adrianosvc/ibc_coupling/amplifier_parts.ods

Label | Quantidade | Part Number | Descrição | Cod. DIGIKEY | Unitário | Valor
R12 | 1 |  | Resistor 0603 16.2k 0.5% | 311-16.2KDCT-ND | 0.2 | 0.2 | 10 kHz Chebyshev 1 dB ripple.
R13 | 1 |  | Resistor 0603 8.87k 0.5% | 311-8.87KDCT-ND | 0.2 | 0.2
R14 | 1 |  | Resistor 0603 24.9k 0.5% | 311-24.9KDCT-ND | 0.2 | 0.2 | For 100 kHz
R15 | 1 |  | Resistor 0603 13.7k 0.5% | 311-2421-1-ND | 0.12 | 0.12 | R12 = 1.62k
C8 | 1 |  | Capacitor PPS 0805 2% 10nF 16V | PCF1177CT-ND | 0.49 | 0.49 | R13 = 887
C9 | 1 |  | Capacitor PPS 0603 2% 180pF 16V | PCF1444CT-ND | 0.49 | 0.49 | R14 = 2.49k
C10 | 1 |  | Capacitor PPS 0603 2% 2.7nF 16V | PCF1458CT-ND | 0.45 | 0.45 | R15 = 1.37k
C11 | 1 |  | Capacitor PPS 0603 2% 1nF 16V | PCF1453CT-ND | 0.45 | 0.45
C3,C4,C5 C6,C7 C12,C13 | 7 |  | Capacitor 100nF 25V X7R 0603 | 445-5667-1-ND | 0.1 | 0.7
C2,C14 | 2 |  | Capacitor 1uF 25V X7R 0603 | 1276-1184-1-ND | 0.1 | 0.2
R1,R2,R8 | 3 |  | Resistor 1 kOhm .1W 0603 | 541-3949-1-ND | 0.1 | 0.3
R10,R11 | 2 |  | Resistor 10 kOhm .1W 0603 | RMCF0603FT10K0CT-ND | 0.1 | 0.2
R3 | 1 |  | Resistor 100 Ohm .1W 0603 | RMCF0603FT100RCT-ND | 0.1 | 0.1
R7 | 1 |  | Resistor 160 kOhm .1W 0603 | 541-160KHCT-ND | 0.1 | 0.1
R4,R5,R6 | 3 |  | Resistor 1.78 kOhm .1W 0603 | RMCF0603FT1K78CT-ND | 0.1 | 0.3
R9 | 1 |  | Resistor 66.5 kOhm .1W 0603 | 311-66.5KHRCT-ND | 0.1 | 0.1
C1 | 1 |  | Capacitor 4.7nF X7R 16V 0603 | 399-9091-1-ND | 0.1 | 0.1
D1,D2,D3 D4,D5,D6 | 6 | FDLL333 | Diodo baixa corrente de fuga SOD-80 | FDLL333CT-ND | 0.27 | 1.62
IC1 | 1 | INA819 | Amplificador de instrumentação SOIC-8 | 296-53403-ND | 5.74 | 5.74
IC3 | 1 | TLV4171 | Amplificador operacional quádruplo SOIC-14 | 296-46563-1-ND | 1.71 | 1.71
IC2 | 1 | TLV2171 | Amplificador operacional duplo SOIC-8 | 296-44865-1-ND | 1.28 | 1.28
 |  |  |  |  | TOTAL (US$) | 15.05
