adrianosvc/ibc_coupling/driver_parts.ods

ID | Quantidade | Part Number | Descrição | Cod. DIGIKEY | Unitário | Valor
IC1, IC2 | 2 | TL487A | Conversor chaveado SOIC-14 | 296-10195-1-ND | 1.67 | 3.34
C1,C6,C11,C12,C14 | 5 |  | Cap. 100uF 25V low-ESR | 399-6118-ND | 0.27 | 1.35
L1,L2 | 2 |  | Indutor 220uH 600mA | 587-6014-1-ND | 0.32 | 0.64
R1,R2 | 2 |  | Resistor 1 Ohm .25W 1206 | 541-1.00FFCT-ND | 0.1 | 0.2
R7,R8 | 2 |  | Resistor 10 Ohm .1W 0603 | 541-2982-1-ND | 0.1 | 0.2
R4,R5 | 2 |  | Resistor 1.2 kOhm .1W 0603 | P1.20KHCT-ND | 0.1 | 0.2
R3,R6 | 2 |  | Resistor 16.9 kOhm .1W 0603 | 541-16.9KHCT-ND | 0.1 | 0.2
C2,C3,C7,C8,C9, C10,C13,C15 | 8 |  | Capacitor 100 nF 25V X7R 0603 | 445-5667-1-ND | 0.1 | 0.8
D1,D2,D3 | 3 | MBR05030T1G | Diodo Schottky 500mA SOD-23 | MBR0530T1GOSCT-ND | 0.39 | 1.17
IC3 | 1 | LM78L15 | Regulador de tensão Linear TO-92 | 497-13129-ND | 0.36 | 0.36
IC4 | 1 | LM79L15 | Regulador de tensão Linear TO-92 | MC79L15ACPREGOSCT-ND | 0.42 | 0.42
IC5,IC6 | 2 | LM324KADR | Amplificador operacional SOIC-14 | 296-18447-1-ND | 0.51 | 1.02
Q1,Q3,Q5 | 3 | BC846 | Transistor NPN uso geral SOT-23 | BC846BLT3GOSCT-ND | 0.14 | 0.42
Q2,Q4 | 2 | BC856 | Transistor PNP uso geral SOT-23 | BC856BLT1GOSCT-ND | 0.14 | 0.28
C4,C5 | 2 |  | Capacitor 270 pF 50 V C0G 0603 | 1276-1256-1-ND | 0.1 | 0.2
C16 | 1 |  | Capacitor 470 nF 25 V X7R 0603 | 732-7993-1-ND | 0.1 | 0.1
R12,R16,R17, R18,R19,R20 | 6 |  | Resistor 1 kOhm .1W 0603 | 541-3949-1-ND | 0.1 | 0.6
R9,R23,R25 | 3 |  | Resistor 2 kOhm .1W 0603 | 541-3953-1-ND | 0.1 | 0.3
R24,R26 | 2 |  | Resistor 510 Ohm .1W 0603 | 541-510HCT-ND | 0.1 | 0.2
R14 | 1 |  | Resistor 976 Ohm .1W 0603 | 311-976HRCT-ND | 0.1 | 0.1
R11 | 1 |  | Resistor 1.47 kOhm .1W 0603 | RMCF0603FT1K47CT-ND | 0.1 | 0.1
R15 | 1 |  | Resistor 14.7 kOhm .1W 0603 | RMCF0603FT14K7CT-ND | 0.1 | 0.1
R10 | 1 |  | Resistor 13 kOhm .1W 0603 | RMCF0603FT13K0CT-ND | 0.1 | 0.1
R13 | 1 |  | Resistor 4.87 kOhm .1W 0603 | RMCF0603FT4K87CT-ND | 0.1 | 0.1
 |  |  |  |  | TOTAL (US$) | 12.5
