adrianosvc/ibc_coupling/driver.pdf

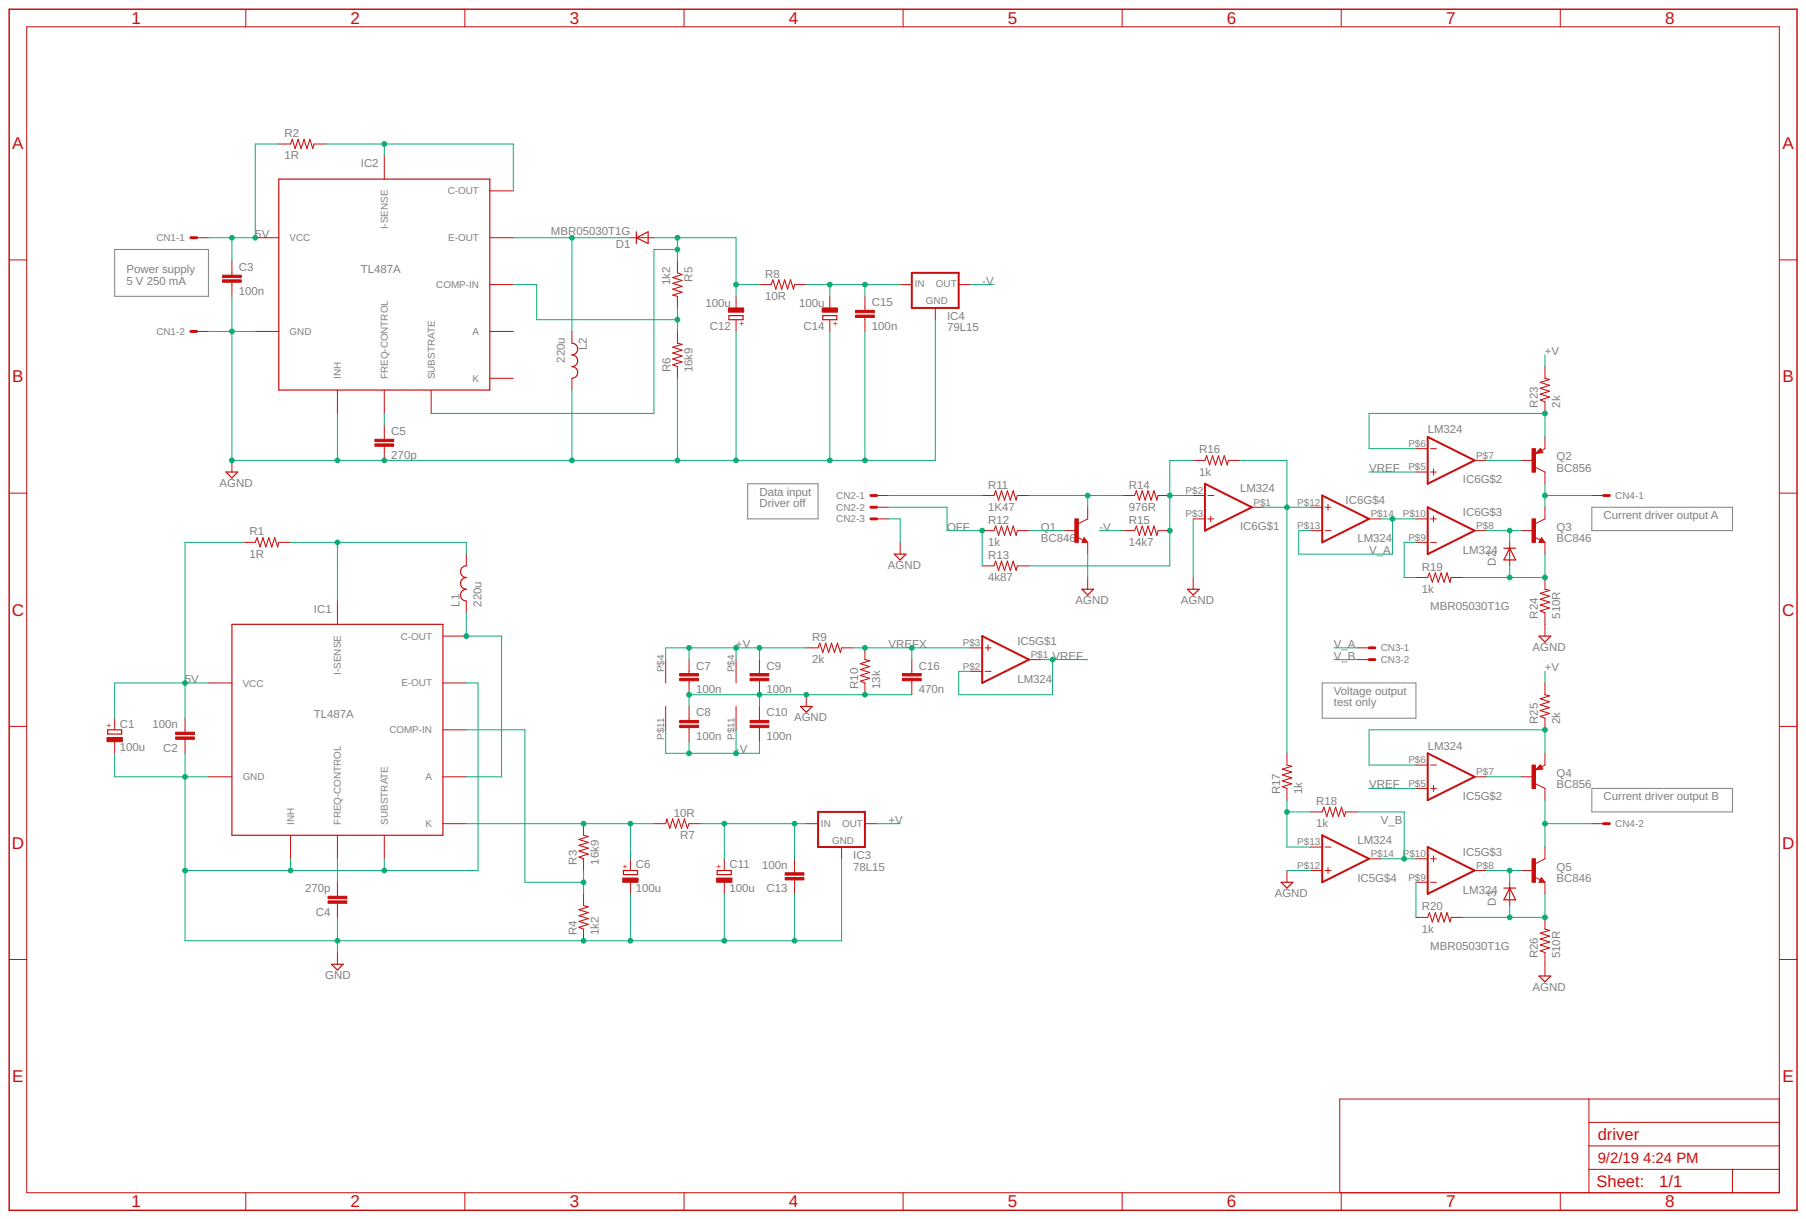
[picture p2: page 1]

Data input Driver off
