adrianosvc/ibc_coupling/amplifier.pdf

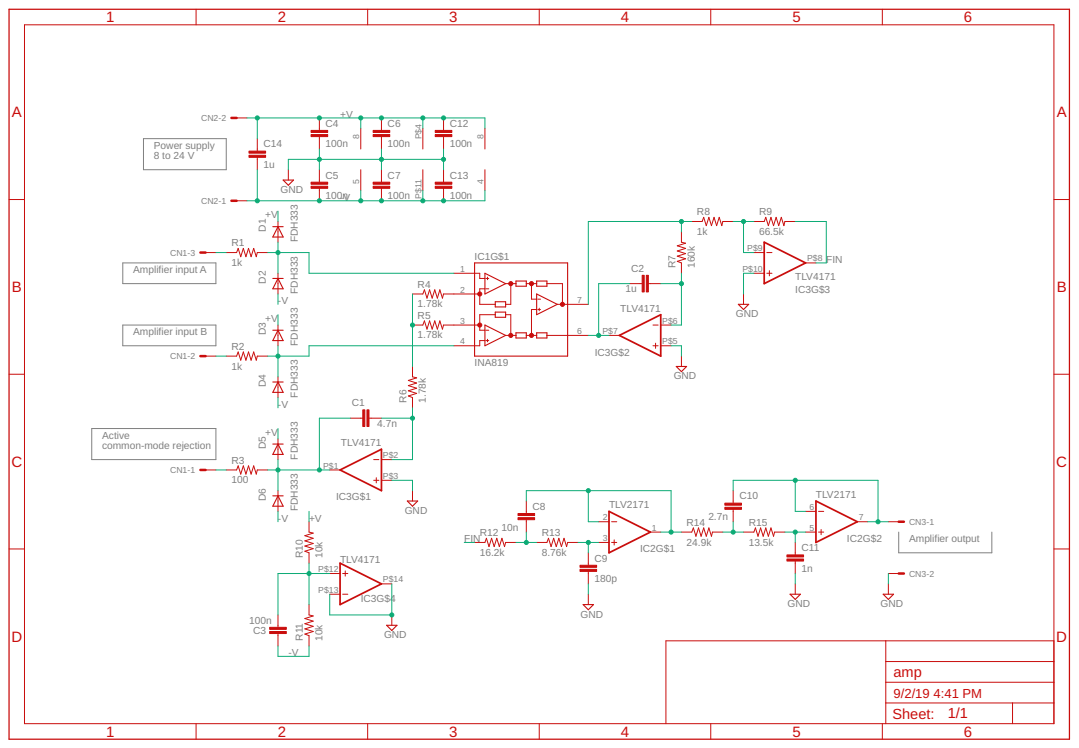
[picture p3: page 1]
